ElvisAlive-Tone/HydraDelayTaptempoBuddy/(list of files, drawings)

Other design files:
FV1BuddyForHydra.dch
FV1BuddyForHydra.dip
