ElvisAlive-Tone/HydraDelayTaptempoBuddy/(commit log)

2025-09-06 initial commit with already modified firmware source code
    [FV1BuddyForHydra.dch]
2025-09-06 documentation improved
    [FV1BuddyForHydra.dch]
2025-09-06 fw- `if`s of the Tap button handling state machine optimized
2026-03-30 PCB designed
    [FV1BuddyForHydra.dch, FV1BuddyForHydra.dip]
2026-03-30 schematics, BOM and PBC in readme
2026-08-01 PWM calibrated, corrected Ramp function added on long tap
    [main.c]
2026-08-02 Shortened log tap time, docs improved
    [main.c]
2026-08-04 changes from final testing
    [FV1BuddyForHydra.dch, FV1BuddyForHydra.dip]
